Orbital-CubeSat-McGill/satcomms-ocs-rf-1.0/README.md

# satcomms-ocs-rf-1.0
OCS-RF-1.0 Project by OCS 3 (the green board)
