Orbital-CubeSat-McGill/satcomms-ocs-rf-1.0/hardware/README.md

KiCad Project for the green board

library path should be added to enviorment variables to show up, or you can just import it with symbol/footprint editor
