Orbital-CubeSat-McGill/satcomms-ocs-rf-1.0/hardware/OCS-RF-1-hardware/OCS-RF-1/OCS-RF-1.kicad_pcb

## KiCad design hardware/OCS-RF-1-hardware/OCS-RF-1/OCS-RF-1.kicad_pcb (2026-10-29)

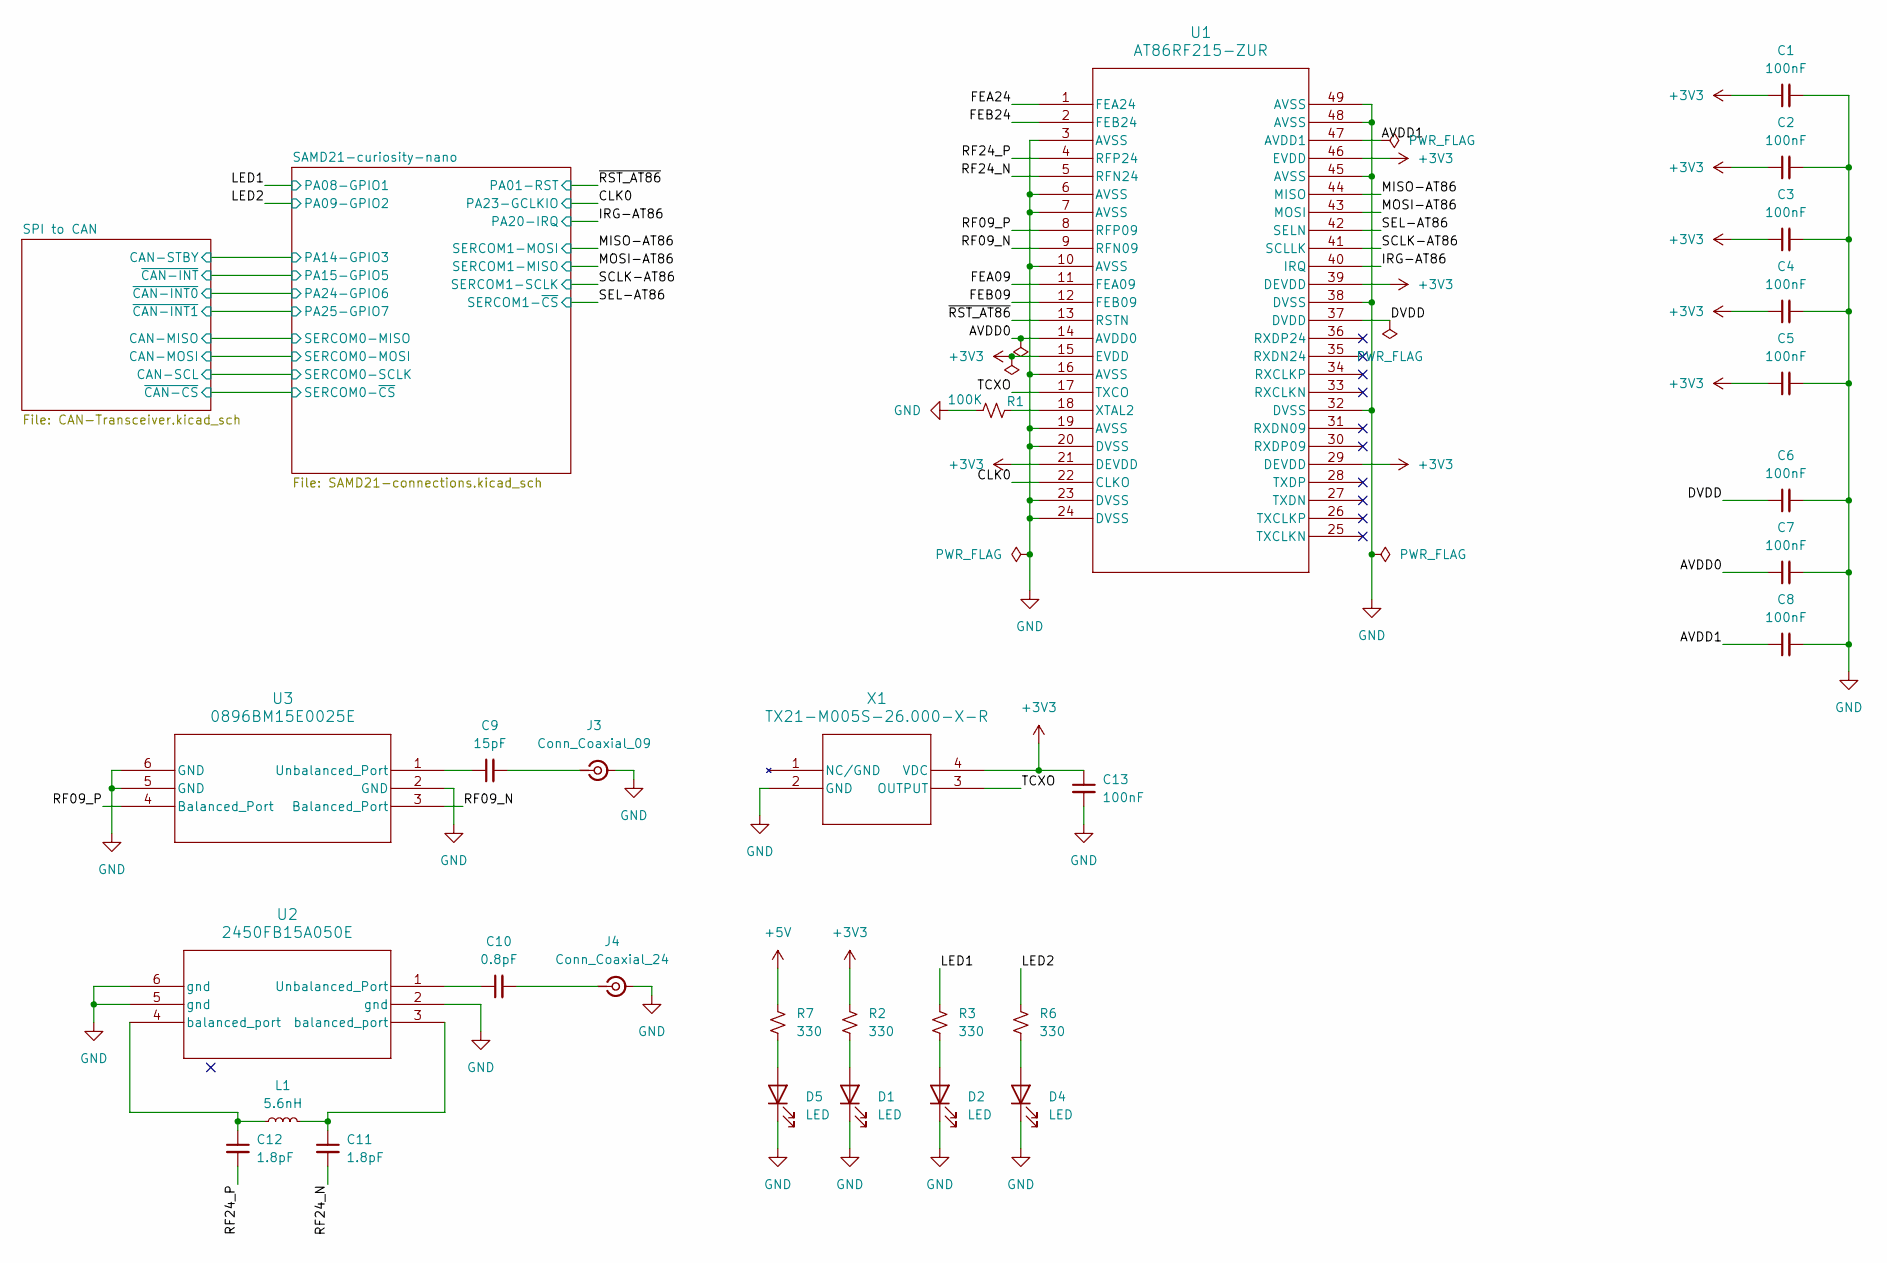
[picture p1: schematic OCS-RF-1.kicad_sch, OCS_RF-1]

Parts:
C1, C2, C3, C4, C5, C6, C7, C8, C13: 100nF; C_0603_1608Metric_Pad1.08x0.95mm_HandSolder
C9: 15pF; C_0402_1005Metric
C10: 0.8pF; C_0402_1005Metric
C11, C12: 1.8pF; C_0402_1005Metric
D1, D2, D4, D5: LED; LED_0603_1608Metric_Pad1.05x0.95mm_HandSolder
J3: Conn_Coaxial_09; SMA_Samtec_SMA-J-P-H-ST-EM1_EdgeMount
J4: Conn_Coaxial_24; SMA_Samtec_SMA-J-P-H-ST-EM1_EdgeMount
L1: 5.6nH; L_0402_1005Metric
R1: 100K; R_0603_1608Metric_Pad0.98x0.95mm_HandSolder
R2, R3, R6, R7: 330; R_0603_1608Metric_Pad0.98x0.95mm_HandSolder
U1: AT86RF215-ZUR; QFN48_PQ_MCH
U2: 2450FB15A050E; 2450FB15A050E_JOT
U3: 0896BM15E0025E; 0896BM15E0025E_JOT
X1: TX21-M005S-26.000-X-R; TX21_2x1p6_SMD_AKR

Connections:
+3V3: C1.1, C2.1, C3.1, C4.1, C5.1, C13.1, R2.1, U1.15 (EVDD), U1.21 (DEVDD), U1.29 (DEVDD), U1.39 (DEVDD), U1.46 (EVDD), X1.4 (VDC); also elsewhere on the board
+5V: R7.1; also elsewhere on the board
/AVDD0: C7.1, U1.14 (AVDD0)
/AVDD1: C8.1, U1.47 (AVDD1)
/CLK0: U1.22 (CLKO); also elsewhere on the board
/DVDD: C6.1, U1.37 (DVDD)
/FEA09: U1.11 (FEA09)
/FEA24: U1.1 (FEA24)
/FEB09: U1.12 (FEB09)
/FEB24: U1.2 (FEB24)
/IRG-AT86: U1.40 (IRQ); also elsewhere on the board
/LED1: R3.1; also elsewhere on the board
/LED2: R6.1; also elsewhere on the board
/MISO-AT86: U1.44 (MISO); also elsewhere on the board
/MOSI-AT86: U1.43 (MOSI); also elsewhere on the board
/RF09_N: U1.9 (RFN09), U3.3 (Balanced_Port)
/RF09_P: U1.8 (RFP09), U3.4 (Balanced_Port)
/RF24_N: C11.2, U1.5 (RFN24)
/RF24_P: C12.2, U1.4 (RFP24)
/SCLK-AT86: U1.41 (SCLLK); also elsewhere on the board
/SEL-AT86: U1.42 (SELN); also elsewhere on the board
/TCXO: U1.17 (TXCO), X1.3 (OUTPUT)
/~RST_AT86: U1.13 (RSTN); also elsewhere on the board
GND: C1.2, C2.2, C3.2, C4.2, C5.2, C6.2, C7.2, C8.2, C13.2, D1.1 (K), D2.1 (K), D4.1 (K), D5.1 (K), J3.2 (Ext), J4.2 (Ext), R1.2, U1.3 (AVSS), U1.6 (AVSS), U1.7 (AVSS), U1.10 (AVSS), U1.16 (AVSS), U1.19 (AVSS), U1.20 (DVSS), U1.23 (DVSS), U1.24 (DVSS), U1.32 (DVSS), U1.38 (DVSS), U1.45 (AVSS), U1.48 (AVSS), U1.49 (AVSS), U2.2 (gnd), U2.5 (gnd), U2.6 (gnd), U3.2 (GND), U3.5 (GND), U3.6 (GND), X1.2 (GND); also elsewhere on the board
unnamed: C11.1, L1.2, U2.3 (balanced_port)
unnamed: C12.1, L1.1, U2.4 (balanced_port)
unnamed: D1.2 (A), R2.2
unnamed: D2.2 (A), R3.2
unnamed: D4.2 (A), R6.2
unnamed: D5.2 (A), R7.2
unnamed: C9.2, J3.1 (In)
unnamed: C10.2, J4.1 (In)
unnamed: R1.1, U1.18 (XTAL2)
unnamed: C10.1, U2.1 (Unbalanced_Port)
unnamed: C9.1, U3.1 (Unbalanced_Port)

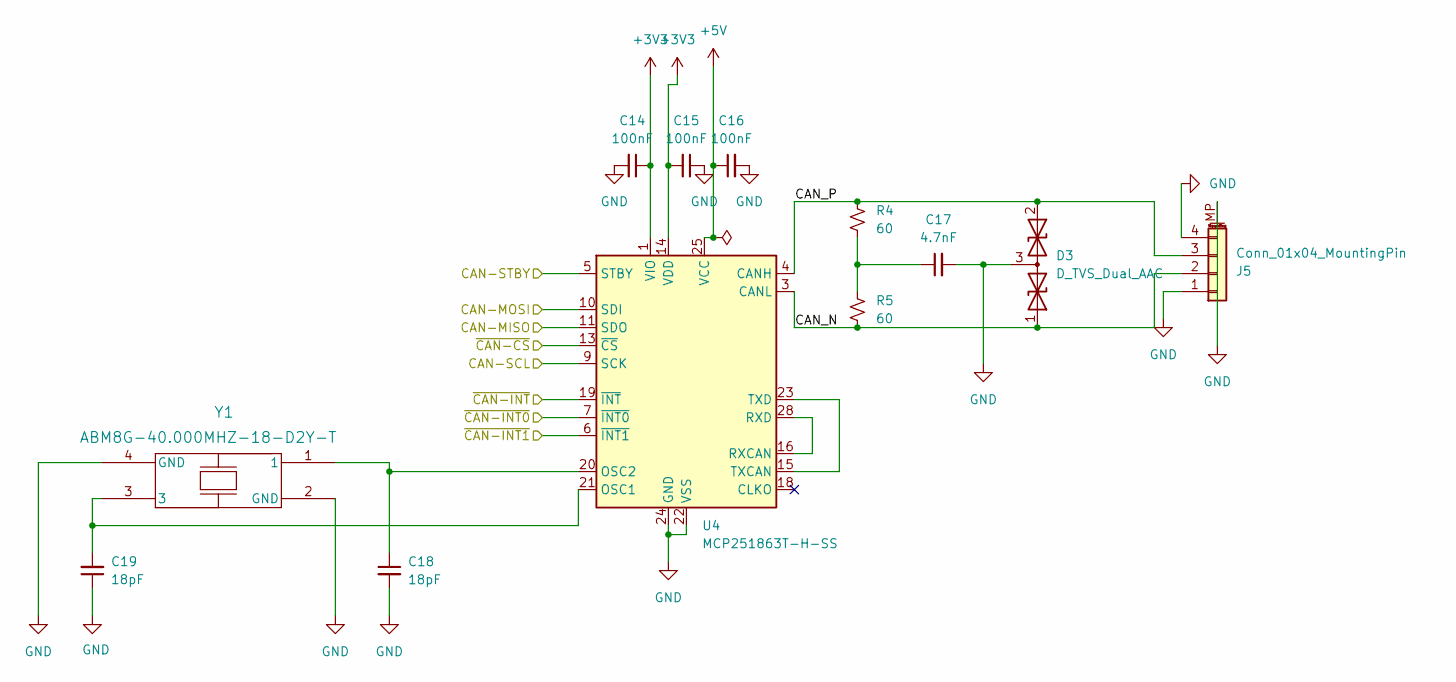
[picture p2: schematic CAN-Transceiver.kicad_sch, SPI to CAN]

Parts:
C14, C15, C16: 100nF; C_0603_1608Metric_Pad1.08x0.95mm_HandSolder
C17: 4.7nF; C_0603_1608Metric_Pad1.08x0.95mm_HandSolder
C18, C19: 18pF; C_0603_1608Metric_Pad1.08x0.95mm_HandSolder
D3: D_TVS_Dual_AAC; SOT-23
J5: Conn_01x04_MountingPin; JST_SH_SM04B-SRSS-TB_1x04-1MP_P1.00mm_Horizontal
R4, R5: 60; R_0603_1608Metric_Pad0.98x0.95mm_HandSolder
U4: MCP251863T-H-SS; SSOP-28_5.3x10.2mm_P0.65mm
Y1: ABM8G-40.000MHZ-18-D2Y-T; CRYSTAL_ABM8G_ABR

Connections:
+3V3: C14.1, C15.2, U4.1 (VIO), U4.14 (VDD); also elsewhere on the board
+5V: C16.1, U4.25 (VCC); also elsewhere on the board
/SAMD21-curiosity-nano/PA14-GPIO3: U4.5 (STBY); also elsewhere on the board
/SAMD21-curiosity-nano/PA15-GPIO5: U4.19 (~INT); also elsewhere on the board
/SAMD21-curiosity-nano/PA24-GPIO6: U4.7 (~INT0); also elsewhere on the board
/SAMD21-curiosity-nano/PA25-GPIO7: U4.6 (~INT1); also elsewhere on the board
/SAMD21-curiosity-nano/SERCOM0-MISO: U4.11 (SDO); also elsewhere on the board
/SAMD21-curiosity-nano/SERCOM0-MOSI: U4.10 (SDI); also elsewhere on the board
/SAMD21-curiosity-nano/SERCOM0-SCLK: U4.9 (SCK); also elsewhere on the board
/SAMD21-curiosity-nano/SERCOM0-~CS: U4.13 (~CS); also elsewhere on the board
/SPI to CAN/CAN_N: D3.1 (A1), J5.2, R5.2, U4.3 (CANL)
/SPI to CAN/CAN_P: D3.2 (A2), J5.3, R4.1, U4.4 (CANH)
GND: C14.2, C15.1, C16.2, C17.2, C18.2, C19.1, D3.3 (common), J5.1, J5.4, J5.MP (MountPin), U4.22 (VSS), U4.24 (GND), Y1.2 (GND), Y1.4 (GND); also elsewhere on the board
unnamed: C17.1, R4.2, R5.1
unnamed: C19.2, U4.21 (OSC1), Y1.3
unnamed: C18.1, U4.20 (OSC2), Y1.1
unnamed: U4.16 (RXCAN), U4.28 (RXD)
unnamed: U4.15 (TXCAN), U4.23 (TXD)

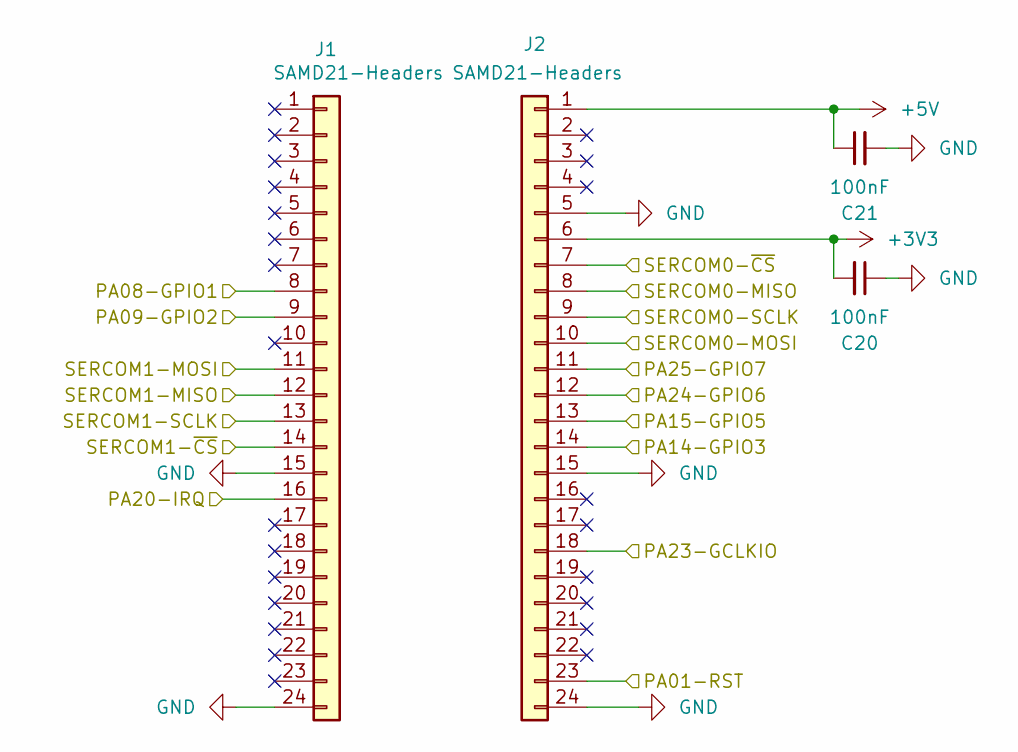
[picture p3: schematic SAMD21-connections.kicad_sch]

Parts:
C20, C21: 100nF; C_0603_1608Metric_Pad1.08x0.95mm_HandSolder
J1, J2: SAMD21-Headers; PinHeader_1x24_P2.54mm_Vertical

Connections:
+3V3: C20.2, J2.6; also elsewhere on the board
+5V: C21.1, J2.1; also elsewhere on the board
/CLK0: J2.18; also elsewhere on the board
/IRG-AT86: J1.16; also elsewhere on the board
/LED1: J1.8; also elsewhere on the board
/LED2: J1.9; also elsewhere on the board
/MISO-AT86: J1.11; also elsewhere on the board
/MOSI-AT86: J1.12; also elsewhere on the board
/SAMD21-curiosity-nano/PA14-GPIO3: J2.14; also elsewhere on the board
/SAMD21-curiosity-nano/PA15-GPIO5: J2.13; also elsewhere on the board
/SAMD21-curiosity-nano/PA24-GPIO6: J2.12; also elsewhere on the board
/SAMD21-curiosity-nano/PA25-GPIO7: J2.11; also elsewhere on the board
/SAMD21-curiosity-nano/SERCOM0-MISO: J2.8; also elsewhere on the board
/SAMD21-curiosity-nano/SERCOM0-MOSI: J2.10; also elsewhere on the board
/SAMD21-curiosity-nano/SERCOM0-SCLK: J2.9; also elsewhere on the board
/SAMD21-curiosity-nano/SERCOM0-~CS: J2.7; also elsewhere on the board
/SCLK-AT86: J1.13; also elsewhere on the board
/SEL-AT86: J1.14; also elsewhere on the board
/~RST_AT86: J2.23; also elsewhere on the board
GND: C20.1, C21.2, J1.15, J1.24, J2.5, J2.15, J2.24; also elsewhere on the board

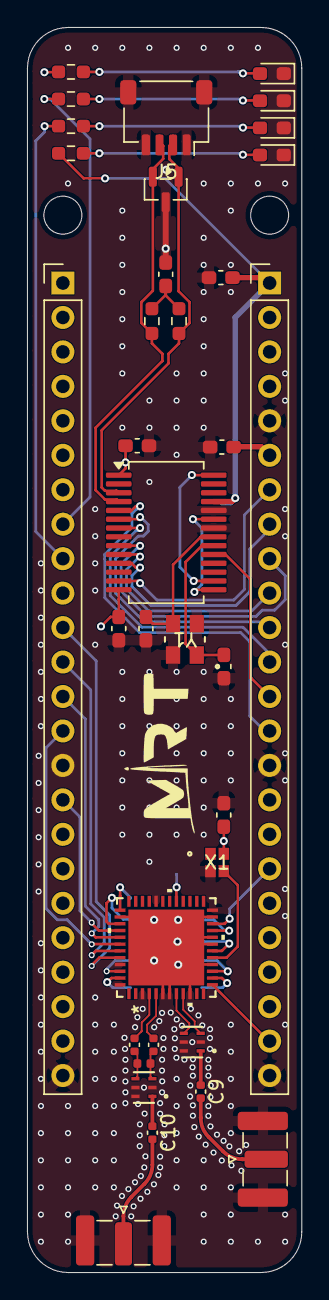
[picture p4: board OCS-RF-1.kicad_pcb from above]

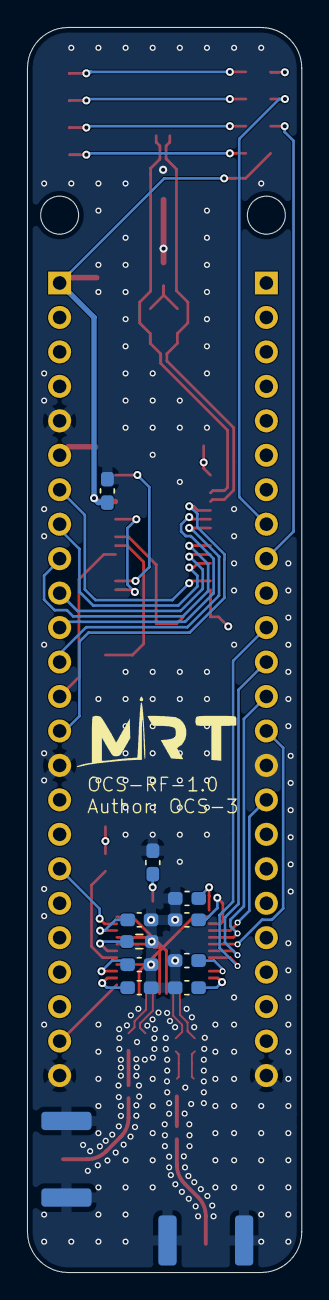
[picture p5: board OCS-RF-1.kicad_pcb from below]

Board: 4 copper layers, 20.2 x 91.8 mm, 45 parts (10 on the bottom side), 46 nets.
