Orbital-CubeSat-McGill/satcomms-ocs-rf-1.0/(commit log)

2026-10-02 Add ocs_rf_1 board definition. LED and button defined, blinky builds, not yet flashed or tested
2026-10-06 Added support directory to specify debugger driver and added two lines to activate 32K oscillator in defconfig file
2026-10-15 confirmed button, blinky, and console outputs work
2026-10-22 device tree pending pin confirmation
2026-10-29 first attempt at the device driver model, code not even close to compile
2026-10-30 some progress on the driver, work done in worksession
2026-10-30 finally set up init function of the driver
2026-10-30 initial spi definitions written
2026-10-31 fixes after spi implementation
